Zaali0416/MSD/WhatsApp Image 2026-06-11 at 1.01.36 PM (2).jpeg

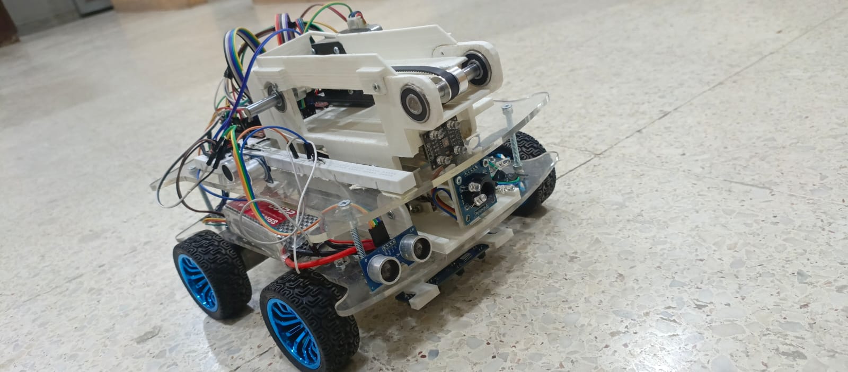
WhatsApp Image 2026-06-11 at 1.01.36 PM (2).jpeg
